cgdailly/-C-lock_In_Smart_Clock-Spring_2026/Alarm_Clock_body.3mf

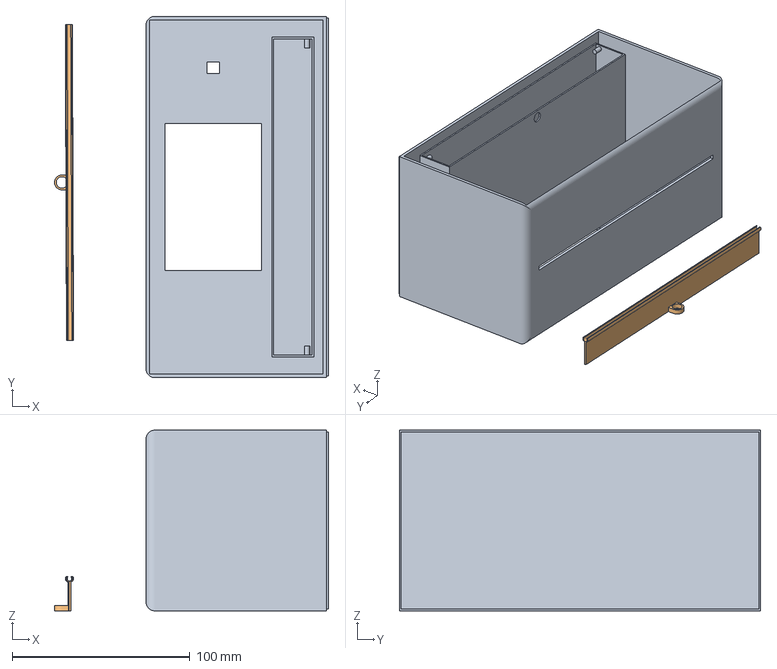
[picture p7: CAD file, 2026-09-25]
Alarm_Clock_body.3mf
154.0 x 203.2 x 101.6 mm
Alarm_Clock_body.stl
Alarm_Clock_door (1).stl
