cgdailly/-C-lock_In_Smart_Clock-Spring_2026/Alarm_Clock_Base.stl

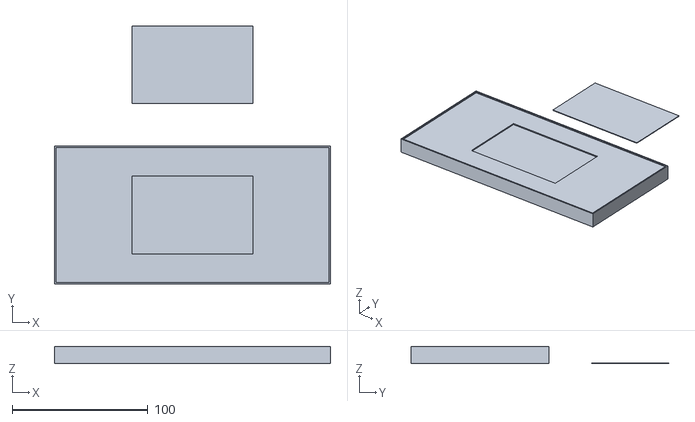
[picture p8: CAD file, 2026-09-25]
Alarm_Clock_Base.stl
203.2 x 189.9 x 12.7
