cgdailly/-C-lock_In_Smart_Clock-Spring_2026/Back_Door_Clock.stl

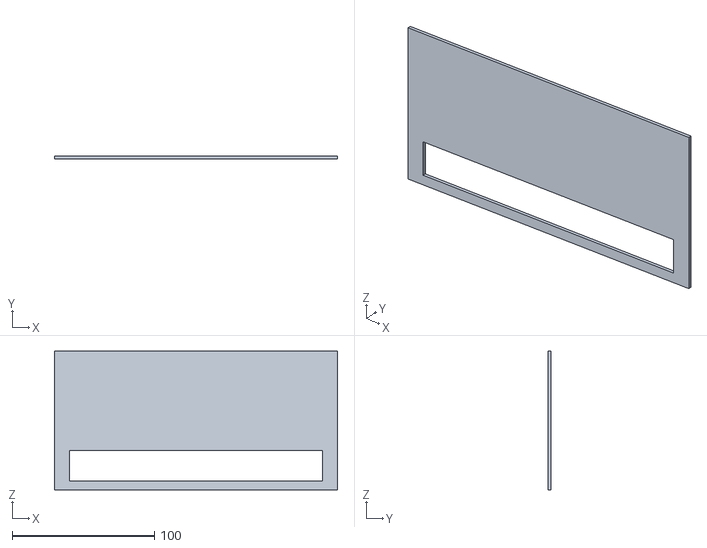
[picture p9: CAD file, 2026-09-25]
Back_Door_Clock.stl
199.2 x 2.00 x 97.6
